altunsumerve/LCR-T4-display-replacement-OLED/(commit log)

2026-10-04 LCR-T4 display replacement: LGT8F328P firmware + 0.96" OLED
    - docs: board identification (LGT8F328P, not ATmega328P), SWD header pinout,
    LCD flex pad map, OLED wiring, flashing with an Arduino Uno, lessons learned
    - firmware: m-firmware 1.42m (DurandA LGT port) + CompuKit TC1 LGT fixes,
    SSD1306 I2C on PD1/PD2, AC0 DAC reference fix, auto-hold; prebuilt hex
    - tools: read-only LGT SWD ID reader, pin finder, LarduinoISP 19200 notes
2026-10-05 Add photos, annotated board images and the repair video
    - docs/img: broken LCD, finished OLED in case, OLED module,
    board back with SWD header pinout and part labels, LCD flex pads
    - README (EN/TR), HARDWARE, FLASHING, LESSONS: images and YouTube link
2026-10-05 Number the LCD flex pads, add soldering photos
    - lcd-flex-pads-annotated: pads 1-14 counted from the SWD-header end,
    PD0/PD1/GND/PD2/PD4 labels with measured pin-finder voltages
    - new photos: OLED wires on pads 3/5, pin header in the SWD holes
    - docs/README: counting direction stated
2026-10-05 README: show the numbered flex pads and OLED solder photo on the main page
